wizzy713/tracking-camera-tripod/Tripod circuit/board-front.png

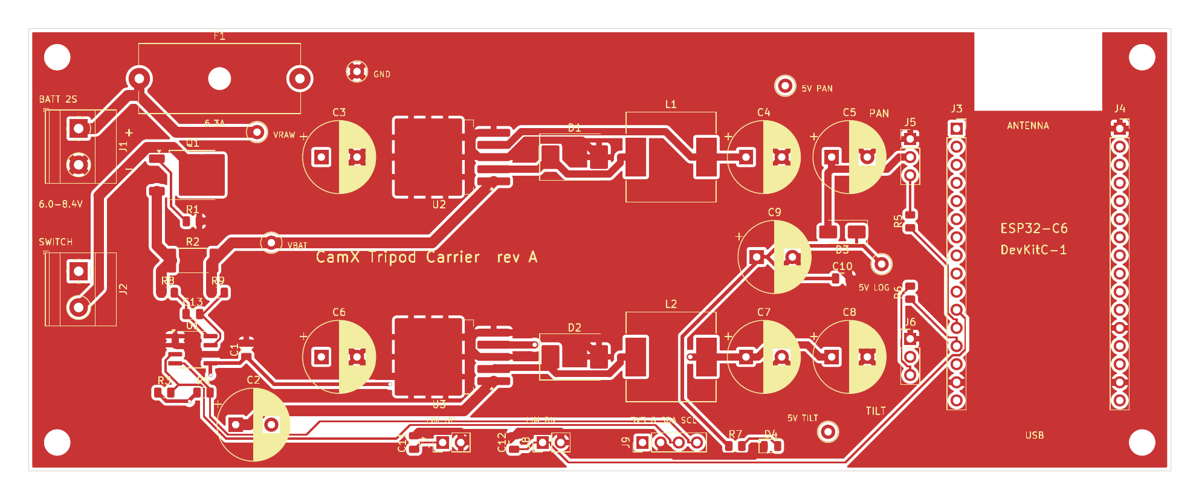
Tripod circuit/board-front.png
