wizzy713/tracking-camera-tripod/Tests/TrackingLog_20260929_215415.csv

# test_name: test2
# test_notes:
# detection_mode: FACE
# prediction_horizon_s: 0.2
# kalman_measurement_noise: 100.0
# kalman_acceleration_noise: 150.0
# tripod_kp: unknown (not synced)
# tripod_ki: unknown (not synced)
# tripod_kd: unknown (not synced)
# tripod_max_speed_offset_us: unknown (not synced)
# tripod_deadzone: unknown (not synced)
Timestamp | FrameTimestampNanos | Seq | DetectionCount | RawX | RawY | FilteredX | FilteredY | VelocityX | VelocityY | DtSeconds | ErrX | ErrY
2026-09-29 21:53:48.750 | 929766907785195 | 711429968 | 0 | NaN | NaN | 240.0 | 320.0 | 0.0 | 0.0 | 0.0 | 0.0 | 0.0
2026-09-29 21:53:48.772 | 929766974423529 | 711429969 | 0 | NaN | NaN | 240.0 | 320.0 | 0.0 | 0.0 | 0.0 | 0.0 | 0.0
2026-09-29 21:53:48.802 | 929767007742487 | 711429970 | 0 | NaN | NaN | 240.0 | 320.0 | 0.0 | 0.0 | 0.0 | 0.0 | 0.0
2026-09-29 21:53:48.832 | 929767041061654 | 711429971 | 0 | NaN | NaN | 240.0 | 320.0 | 0.0 | 0.0 | 0.0 | 0.0 | 0.0
2026-09-29 21:53:48.923 | 929767074380820 | 711429972 | 1 | 25.0 | 19.0 | 25.0 | 19.0 | 0.0 | 0.0 | 0.0 | -0.8958333 | -0.940625
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
