wizzy713/tracking-camera-tripod/Tripod circuit/Tripod circuit schematic.pdf

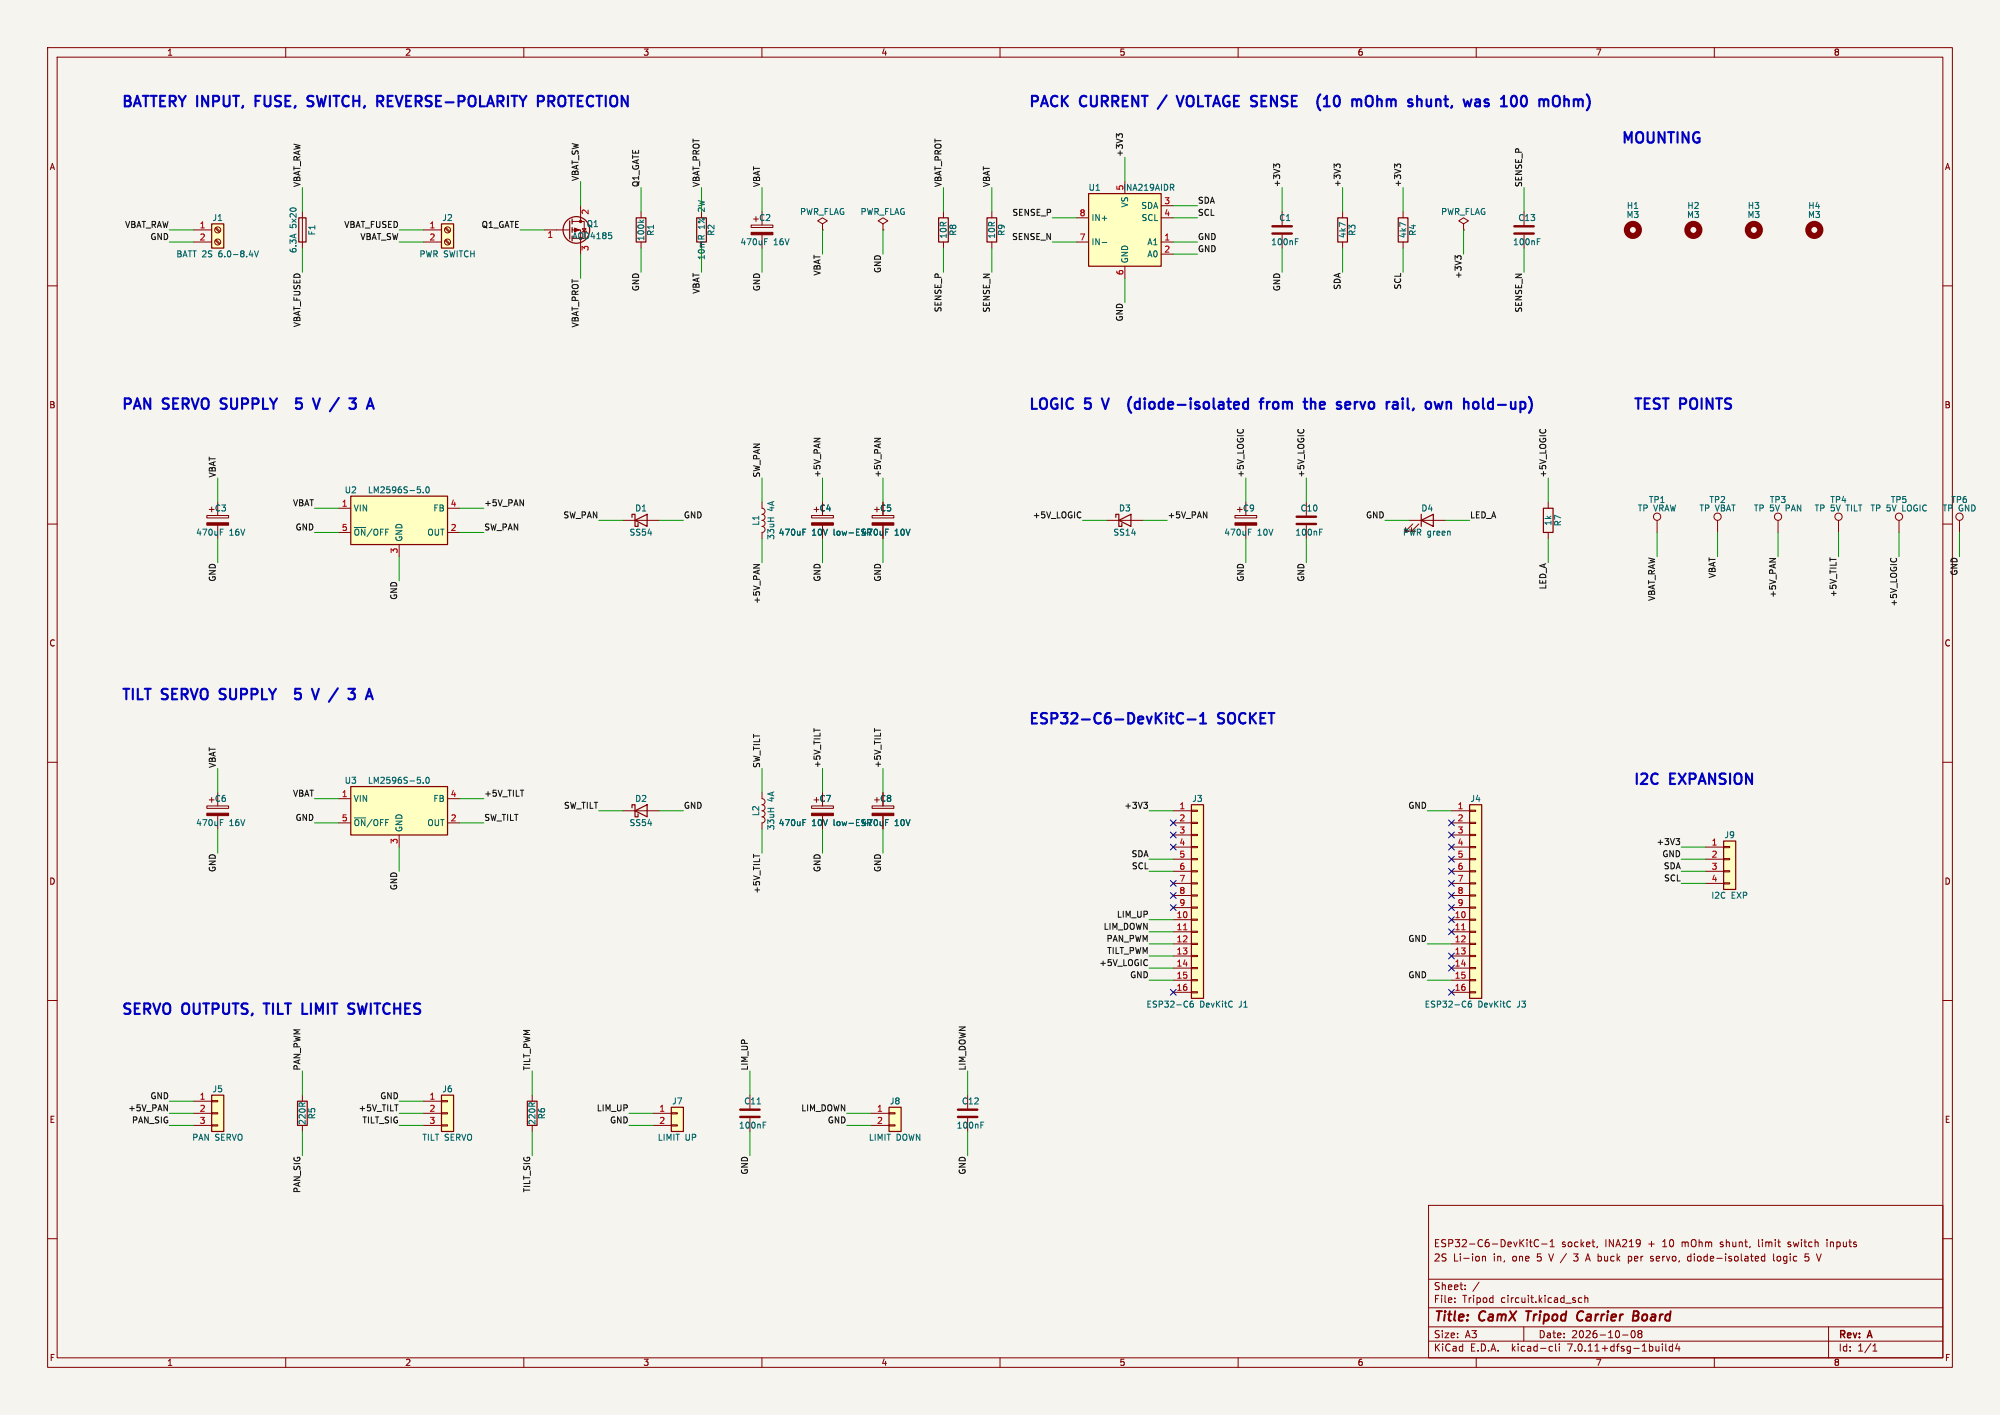
[picture p2: page 1]

SERVO OUTPUTS, TILT LIMIT SWITCHES

Id: 1/1 Title: CamX Tripod Carrier Board
