wizzy713/tracking-camera-tripod/Tripod circuit/Tripod circuit.kicad_pcb

## KiCad design Tripod circuit/Tripod circuit.kicad_pcb (2026-10-12)

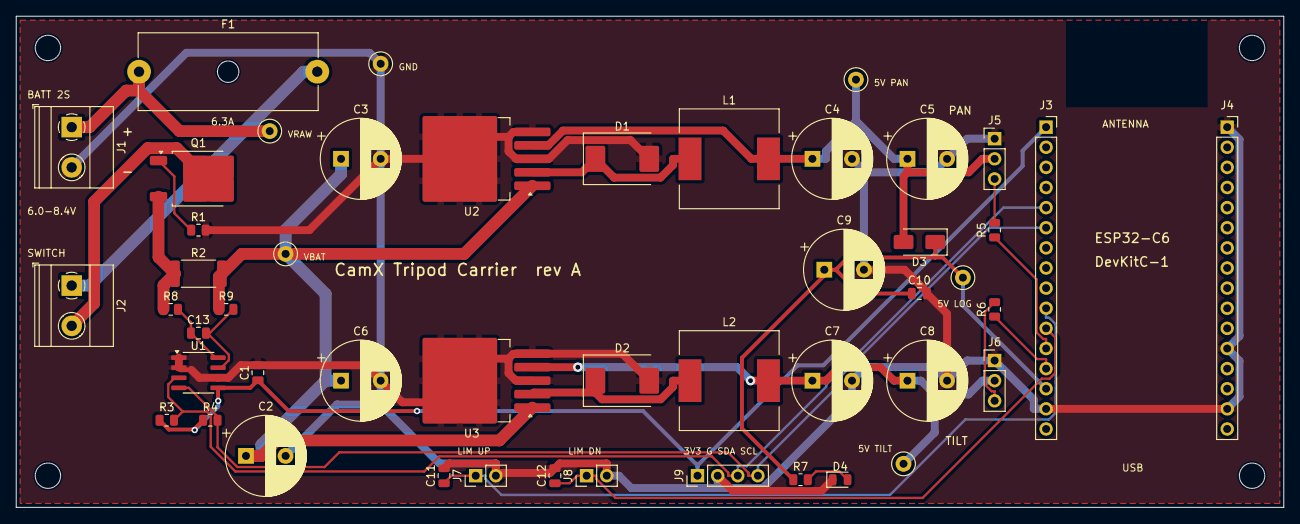
[picture p3: board Tripod circuit.kicad_pcb from above]

Board: 2 copper layers, 160.0 x 62.0 mm, 52 parts (0 on the bottom side), 24 nets.

Parts:
C1, C10, C11, C12, C13: 100nF; C_0805_2012Metric
C2, C3, C6: 470uF 16V; CP_Radial_D10.0mm_P5.00mm
C4, C7: 470uF 10V low-ESR; CP_Radial_D10.0mm_P5.00mm
C5, C8, C9: 470uF 10V; CP_Radial_D10.0mm_P5.00mm
D1, D2: SS54; D_SMC
D3: SS14; D_SMA
D4: PWR green; LED_0805_2012Metric
F1: 6.3A 5x20; Fuseholder_Cylinder-5x20mm_Schurter_0031_8201_Horizontal_Op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
H1, H2, H3, H4: M3; MountingHole_3.2mm_M3
J1: BATT 2S 6.0-8.4V; TerminalBlock_Phoenix_MKDS-1,5-2-5.08_1x02_P5.08mm_Horizont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
J2: PWR SWITCH; TerminalBlock_Phoenix_MKDS-1,5-2-5.08_1x02_P5.08mm_Horizont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
J3: ESP32-C6 DevKitC J1; PinSocket_1x16_P2.54mm_Vertical
J4: ESP32-C6 DevKitC J3; PinSocket_1x16_P2.54mm_Vertical
J5: PAN SERVO; PinHeader_1x03_P2.54mm_Vertical
J6: TILT SERVO; PinHeader_1x03_P2.54mm_Vertical
J7: LIMIT UP; PinHeader_1x02_P2.54mm_Vertical
J8: LIMIT DOWN; PinHeader_1x02_P2.54mm_Vertical
J9: I2C EXP; PinHeader_1x04_P2.54mm_Vertical
L1, L2: 33uH 4A; L_12x12mm_H8mm
Q1: AOD4185; TO-252-2
R1: 100k; R_0805_2012Metric
R2: 10mR 1% 2W; R_2512_6332Metric
R3, R4: 4k7; R_0805_2012Metric
R5, R6: 220R; R_0805_2012Metric
R7: 1k; R_0805_2012Metric
R8, R9: 10R; R_0805_2012Metric
TP1: TP VRAW; TestPoint_Loop_D2.50mm_Drill1.0mm
TP2: TP VBAT; TestPoint_Loop_D2.50mm_Drill1.0mm
TP3: TP 5V PAN; TestPoint_Loop_D2.50mm_Drill1.0mm
TP4: TP 5V TILT; TestPoint_Loop_D2.50mm_Drill1.0mm
TP5: TP 5V LOGIC; TestPoint_Loop_D2.50mm_Drill1.0mm
TP6: TP GND; TestPoint_Loop_D2.50mm_Drill1.0mm
U1: INA219AIDR; SOIC-8_3.9x4.9mm_P1.27mm
U2, U3: LM2596S-5.0; TO-263-5_TabPin3

Connections:
+3V3: C1.1, J3.1, J9.1, R3.1, R4.1, U1.5
+5V_LOGIC: C9.1, C10.1, D3.1, J3.14, R7.1, TP5.1
+5V_PAN: C4.1, C5.1, D3.2, J5.2, L1.2, TP3.1, U2.4
+5V_TILT: C7.1, C8.1, J6.2, L2.2, TP4.1, U3.4
GND: C1.2, C2.2, C3.2, C4.2, C5.2, C6.2, C7.2, C8.2, C9.2, C10.2, C11.2, C12.2, D1.2, D2.2, D4.1, J1.2, J3.15, J4.1, J4.12, J4.15, J5.1, J6.1, J7.2, J8.2, J9.2, R1.2, TP6.1, U1.1, U1.2, U1.6, U2.3, U2.5, U3.3, U3.5
LED_A: D4.2, R7.2
LIM_DOWN: C12.1, J3.11, J8.1
LIM_UP: C11.1, J3.10, J7.1
PAN_PWM: J3.12, R5.1
PAN_SIG: J5.3, R5.2
Q1_GATE: Q1.1, R1.1
SCL: J3.6, J9.4, R4.2, U1.4
SDA: J3.5, J9.3, R3.2, U1.3
SENSE_N: C13.2, R9.2, U1.7
SENSE_P: C13.1, R8.2, U1.8
SW_PAN: D1.1, L1.1, U2.2
SW_TILT: D2.1, L2.1, U3.2
TILT_PWM: J3.13, R6.1
TILT_SIG: J6.3, R6.2
VBAT: C2.1, C3.1, C6.1, R2.2, R9.1, TP2.1, U2.1, U3.1
VBAT_FUSED: F1.2, J2.1
VBAT_PROT: Q1.3, R2.1, R8.1
VBAT_RAW: F1.1, J1.1, TP1.1
VBAT_SW: J2.2, Q1.2
