wizzy713/tracking-camera-tripod/(commit log)

2026-08-01 Initial commit: CamX with ML Kit tracking and 16KB alignment fix
    [MainActivity.kt]
2026-08-02 Implement Kalman Filter for predictive tracking and add comprehensive README
2026-08-12 Stability restoration: Reverted gesture logic, fixed 16KB alignment build conflicts, and updated technical documentation
    [MainActivity.kt]
2026-08-12 Added ESP32 firmware with mDNS auto-discovery and UDP coordinate parsing
2026-08-19 Replace mDNS auto-discovery with manual ESP32 connection setup
    Swap Network Service Discovery for manual IP/port entry to simplify
    hardware pairing, only draw the locked/primary detected object instead
    of every bounding box, and use a manual YUV-to-Bitmap conversion for
    hand landmark detection to avoid crashes from the built-in toBitmap().
    Docs updated to match.
    Claude-Session: https://claude.ai/code/session_01NAVhKXpVwxyNYS3wwAwX5p
2026-08-19 Add GitHub Actions workflow to build and test on push/PR
    Runs assembleDebug and unit tests on JDK 21 for every push and PR
    against main, matching the local build environment (compileSdk 35,
    Gradle 9.6.1).
    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
2026-08-19 Fix Kalman filter covariance update, log thread-safety, and pre-Q storage permission
    - KalmanFilter: the velocity covariance terms (p_vp, p_vv) were being
    computed from p_p/p_pv after those were already overwritten by the
    position update, corrupting the filter's confidence in its velocity
    estimate over time. Compute all four terms from pre-update values.
    - LogManager: `data` was written from the frame-analysis executor
    thread and read/cleared from the UI thread with no synchronization,
    risking a ConcurrentModificationException or lost entries. Guard all
    access with a lock (this also matches ARCHITECTURE.md's existing
    "thread-safe recording" claim, which wasn't actually true bef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
2026-08-19 Fix rotation coordinate-frame bug, front-camera mirror, Kalman tuning, and target-selection races
    Working through the review comments: several were real, uncaught bugs
    spanning the app and firmware protocol together, so they're fixed as
    one coordinated change rather than patched independently.
    KalmanFilter.kt:
    - r=0.1 implied 0.3px measurement noise; real ML Kit box jitter is
    5-15px, so R was effectively a pass-through. Default now 100
    (tunable), and process noise switched from a flat q to a proper
    discrete white-noise-acceleration model.
    - Y axis is now filtered too (a second KalmanFilter instance) --
    previously only X was, so tilt was visibly jerkier than pan.
    - update() now takes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
2026-08-31 Update firmware for ESP32-C6 (WiFi 6): change servo pins and add board notes
    Switches PAN_PIN/TILT_PIN from the classic ESP32's 18/19 to GPIO2/3, which
    are safe on ESP32-C6 boards (avoids strapping pins 4/5/8/9/15 and the
    USB D-/D+ pins 12/13). Adds header notes on required core/library versions
    for C6 compatibility.
2026-08-31 Update firmware README for ESP32-C6 wiring and setup
    Reflects the GPIO2/GPIO3 servo pins and board/library version requirements
    introduced for the ESP32-C6 in the firmware sketch.
2026-08-31 Remove mDNS discovery from firmware to simplify network troubleshooting
    The Android app already uses manual IP/port entry, so mDNS advertisement
    wasn't load-bearing. Dropping it narrows the surface while diagnosing a
    device-to-device connectivity issue on the WiFi network.
2026-08-31 Add serial diagnostics for servo attach and packet parsing on ESP32-C6
    Logs whether panServo/tiltServo successfully attach a PWM/LEDC channel on
    boot, and prints raw/parsed packet data plus each servo write, to isolate
    where a "servo not spinning" report is actually failing (data pipeline vs.
    PWM attach vs. downstream wiring/power).
2026-08-31 Rework firmware for continuous-rotation servos: PID speed control, per-axis neutral, and serial calibration mode
    The original control model accumulated and held an absolute target angle,
    which is correct for positional servos but meaningless for continuous-
    rotation ones (write() sets speed/direction, not position) -- it caused
    the servo to spin indefinitely once nudged off-neutral. Replaces it with
    PID speed control that explicitly commands a stop pulse when the subject
    is centered, adds a loss-of-signal failsafe so a dropped connection can't
    leave a motor spinning, and splits NEUTRAL into per-axis PAN_NEUTRAL/
    TILT_NEUTRAL with a serial command mode (P<0-180>/T<0-180>) to find each
    servo's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
2026-08-31 Fix continuous-rotation servo drift; add hand-skeleton overlay (#1)
    * Ignore Claude Code editor tab-state file
    .idea/claudeCodeTabState.xml is transient per-machine editor state, in the
    same category as the already-ignored workspace.xml.
    Claude-Session: https://claude.ai/code/session_019HAKgA9Qk6uefnAZ1HGaZX
    * Fix continuous-rotation servo drift and add hand-skeleton overlay
    Firmware: the servos were driven via Servo::write(90) as "neutral", which
    against the 500-2400 us attach range emits 1450 us, not the true 1500 us
    center -- a standing ~50 us bias that makes a well-trimmed continuous-
    rotation servo creep one direction forever, and which the small 0-15 speed
    scale (truncated to int)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
2026-08-31 PID: model-based gains, runaway guards, live tuning, boot LED (#2)
    * Derive PID gains from an integrator-plant model
    The gains were hand-guessed (KP=400, KI=200, MAX_SPEED_OFFSET_US=350) and
    would have driven the servo to full-speed spin at ~4% error.
    The plant is a pure integrator: pulse offset u commands camera rate w=Ks*u,
    and the app's error is angle/half_FOV, so de/dt = -(Ks/half_FOV)*u. For an
    integrator the loop delay L alone caps the gain via phase margin:
    w_c = KP*Ks/half_FOV, KP = w_c*half_FOV/Ks, KI = (w_c/6)*KP, KD = 0.
    With Ks~=1.8 deg/s/us (FS90R-class, loaded), half_FOV~=26deg pan / 33deg tilt,
    L~=0.15s, PM target 50deg -> w_c~=3.5 rad/s:
    KP 400 -> 55
    KI 200 -> 30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
2026-09-08 Add INA219 battery monitoring with on-screen fuel gauge (#3)
    Firmware (camx_tripod.ino):
    - Read an INA219 on the high side of the 2S Li-ion pack (before the
    regulator) over I2C (GPIO6/7, addr 0x40). Non-fatal if absent.
    - Blended fuel gauge: coulomb counting seeded from boot open-circuit
    voltage, fused with an IR-compensated per-cell OCV curve. Fusion is
    asymmetric -- the voltage estimate pulls the coulomb counter toward it
    near rest, and only downward under load.
    - Report state of charge back to the app as a UDP reply on the same flow
    the EX/EY packets arrive on: "BATT:<pct>,MV:<mv>,MA:<ma>,WH:<wh>" every 2s.
    - RGB LED encodes charge after boot (green/amber/red/blinking); "?" over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
2026-09-28 Battery monitoring, Experiment tab, and tracking fixes (#5)
    * Add INA219 battery monitoring with on-screen fuel gauge
    - RGB LED enco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
2026-09-29 Feature/experiment
    - RGB LED encodes charge after boot (green/amber/red/bl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
2026-10-02 Ball tracking by colour, tripod auto-connect, Ball-mode crash fix, run-analysis script (#6)
    * Ball tracking by colour, auto-connect, crash fix, run-analysis script
    Ball mode
    - ColorBallDetector: finds an optic-yellow tennis ball by HSV colour on a
    coarse grid, dilating the mask to bridge net strands -- robust where the
    COCO "sports ball" model fails on a ball held in a net. The MediaPipe
    EfficientDet-Lite0 model (now bundled) is only a fallback.
    - BallTracker: nearest-centre ID association so palm lock and coast-on-loss
    work with the per-frame MediaPipe detector. Drop unused ML Kit
    object-detection dependency.
    Crash fix
    - Leaving the camera screen closed the MediaPipe ball detect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
2026-10-12 Improve tracking calibration and controls; add gyro compensation and carrier board
2026-10-12 Feature/ina219 battery monitoring (#9)
    - RGB LED encodes charge after boot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
2026-10-12 Feature/ball tracking autoconnect (#8)
    - Leaving the camera screen closed the MediaPipe ball detector while a
    queued frame could still call detect() o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
